markGilchrist/flightline-motor-controller/board_bottom.png

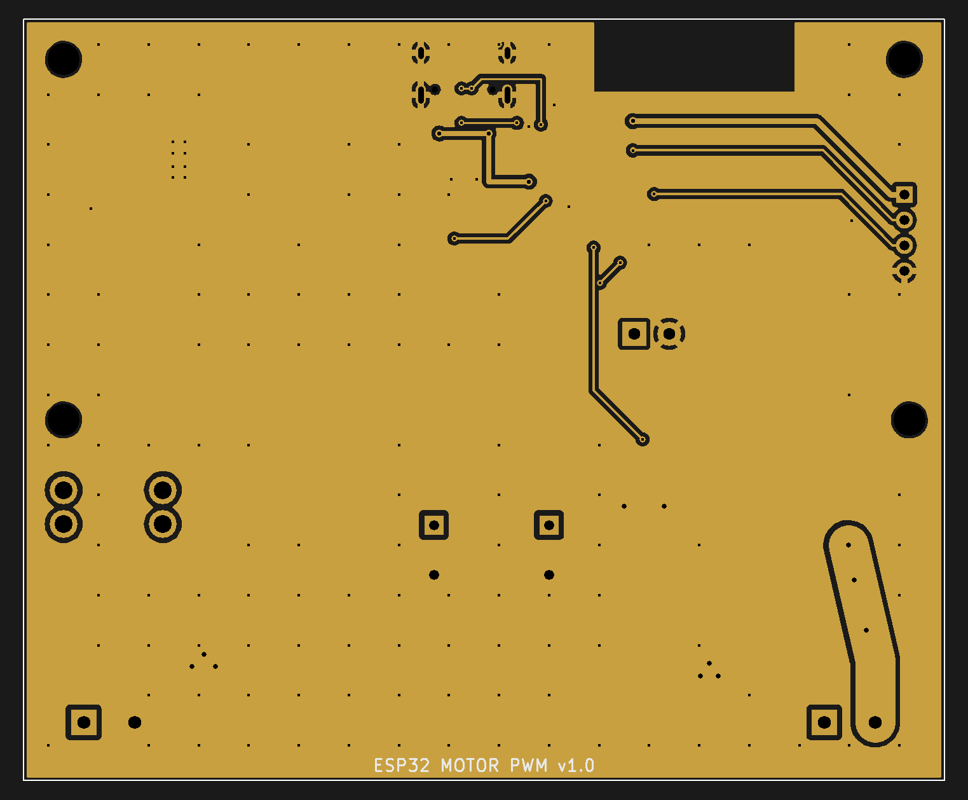
board_bottom.png
