markGilchrist/flightline-motor-controller/board_top.png

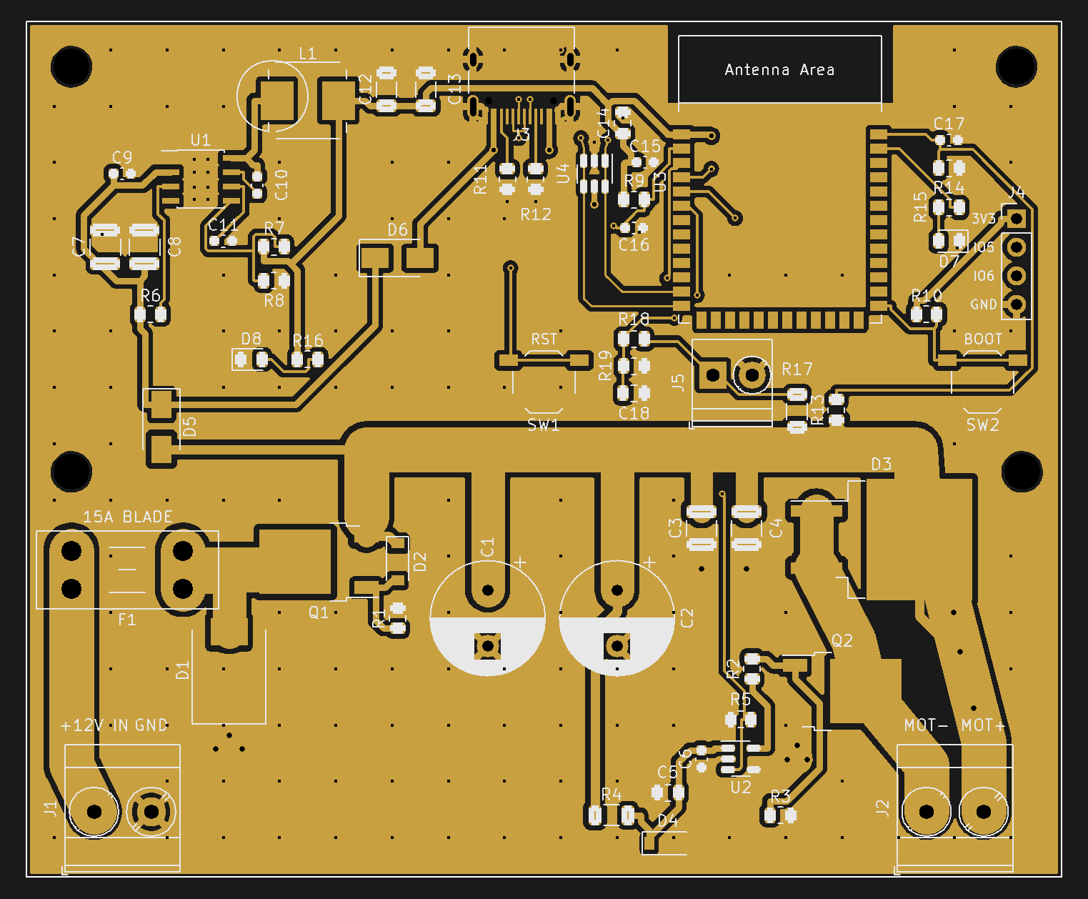
board_top.png
