markGilchrist/flightline-motor-controller/motor_ctrl_BOM.csv

Qty | References | Value | Footprint | Manufacturer part / notes
2 | C1 C2 | 470uF 35V | CP_Radial_D10.0mm_P5.00mm | Panasonic EEU-FR1V471
4 | C3 C4 C7 C8 | 10uF 50V | C_1210_3225Metric | X7R 1210
1 | C5 | 1uF 25V | C_0805_2012Metric
4 | C6 C10 C15 C17 | 100nF | C_0603_1608Metric
1 | C9 | 100nF 50V | C_0603_1608Metric
2 | C11 C16 | 1uF | C_0603_1608Metric
2 | C12 C13 | 22uF 10V | C_1206_3216Metric | X7R 1206
1 | C14 | 10uF | C_0805_2012Metric
1 | C18 | 470nF | C_0805_2012Metric
1 | D1 | SMCJ20CA | D_SMC | Littelfuse SMCJ20CA
2 | D2 D4 | BZT52C12 | D_SOD-123 | BZT52C12
1 | D3 | STPS20L45CG | TO-263-2 | ST STPS20L45CG-TR
2 | D5 D6 | B360A | D_SMA | Diodes B360A-13-F
1 | D7 | GREEN | LED_0805_2012Metric
1 | D8 | RED | LED_0805_2012Metric
1 | F1 | 15A | Fuseholder_Blade_Mini_Keystone_3568 | Keystone 3568 + 15A mini blade fuse
1 | J1 | BATTERY 12V | TerminalBlock_Phoenix_MKDS-3-2-5.08_1x02_P5.08mm_Horizontal | Phoenix 1711026 (MKDS 3/2-5.08)
1 | J2 | MOTOR | TerminalBlock_Phoenix_MKDS-3-2-5.08_1x02_P5.08mm_Horizontal | Phoenix 1711026 (MKDS 3/2-5.08)
1 | J3 | USB-C | USB_C_Receptacle_HRO_TYPE-C-31-M-12 | HRO TYPE-C-31-M-12
1 | J4 | AUX | PinHeader_1x04_P2.54mm_Vertical | 2.54 mm header
1 | J5 | PARK | TerminalBlock_Phoenix_PT-1,5-2-3.5-H_1x02_P3.50mm_Horizontal | Phoenix 1984617 (PT 1,5/2-3,5-H)
1 | L1 | 6.8uH | L_Bourns_SRP7028A_7.3x6.6mm | Bourns SRP7028A-6R8M
1 | Q1 | IPD90P04P4L-04 | TO-252-2 | Infineon IPD90P04P4L-04
1 | Q2 | IPD90N04S4L-04 | TO-252-2 | Infineon IPD90N04S4L-04
4 | R1 R3 R9 R10 | 10k | R_0805_2012Metric
1 | R2 | 10R | R_0805_2012Metric
1 | R4 | 220R | R_1206_3216Metric
2 | R5 R6 | 100k | R_0805_2012Metric
3 | R7 R13 R18 | 100k | R_0805_2012Metric | 1%
1 | R8 | 43.2k | R_0805_2012Metric | 1%
2 | R11 R12 | 5.1k | R_0805_2012Metric
1 | R14 | 18k | R_0805_2012Metric | 1%
2 | R15 R16 | 1k | R_0805_2012Metric
1 | R17 | 4k7 | R_1206_3216Metric
1 | R19 | 10k | R_0805_2012Metric | 1%
1 | SW1 | RESET | SW_SPST_TL3342 | E-Switch TL3342F160QG
1 | SW2 | BOOT | SW_SPST_TL3342 | E-Switch TL3342F160QG
1 | U1 | LMR33630ADDA | TI_SO-PowerPAD-8_ThermalVias | TI LMR33630ADDAR
1 | U2 | UCC27517A | SOT-23-5 | TI UCC27517ADBVR
1 | U3 | ESP32-S3-WROOM-1 | ESP32-S3-WROOM-1 | Espressif ESP32-S3-WROOM-1-N8
1 | U4 | USBLC6-2SC6 | SOT-23-6 | ST USBLC6-2SC6
