markGilchrist/flightline-motor-controller/motor_ctrl_schematic.pdf

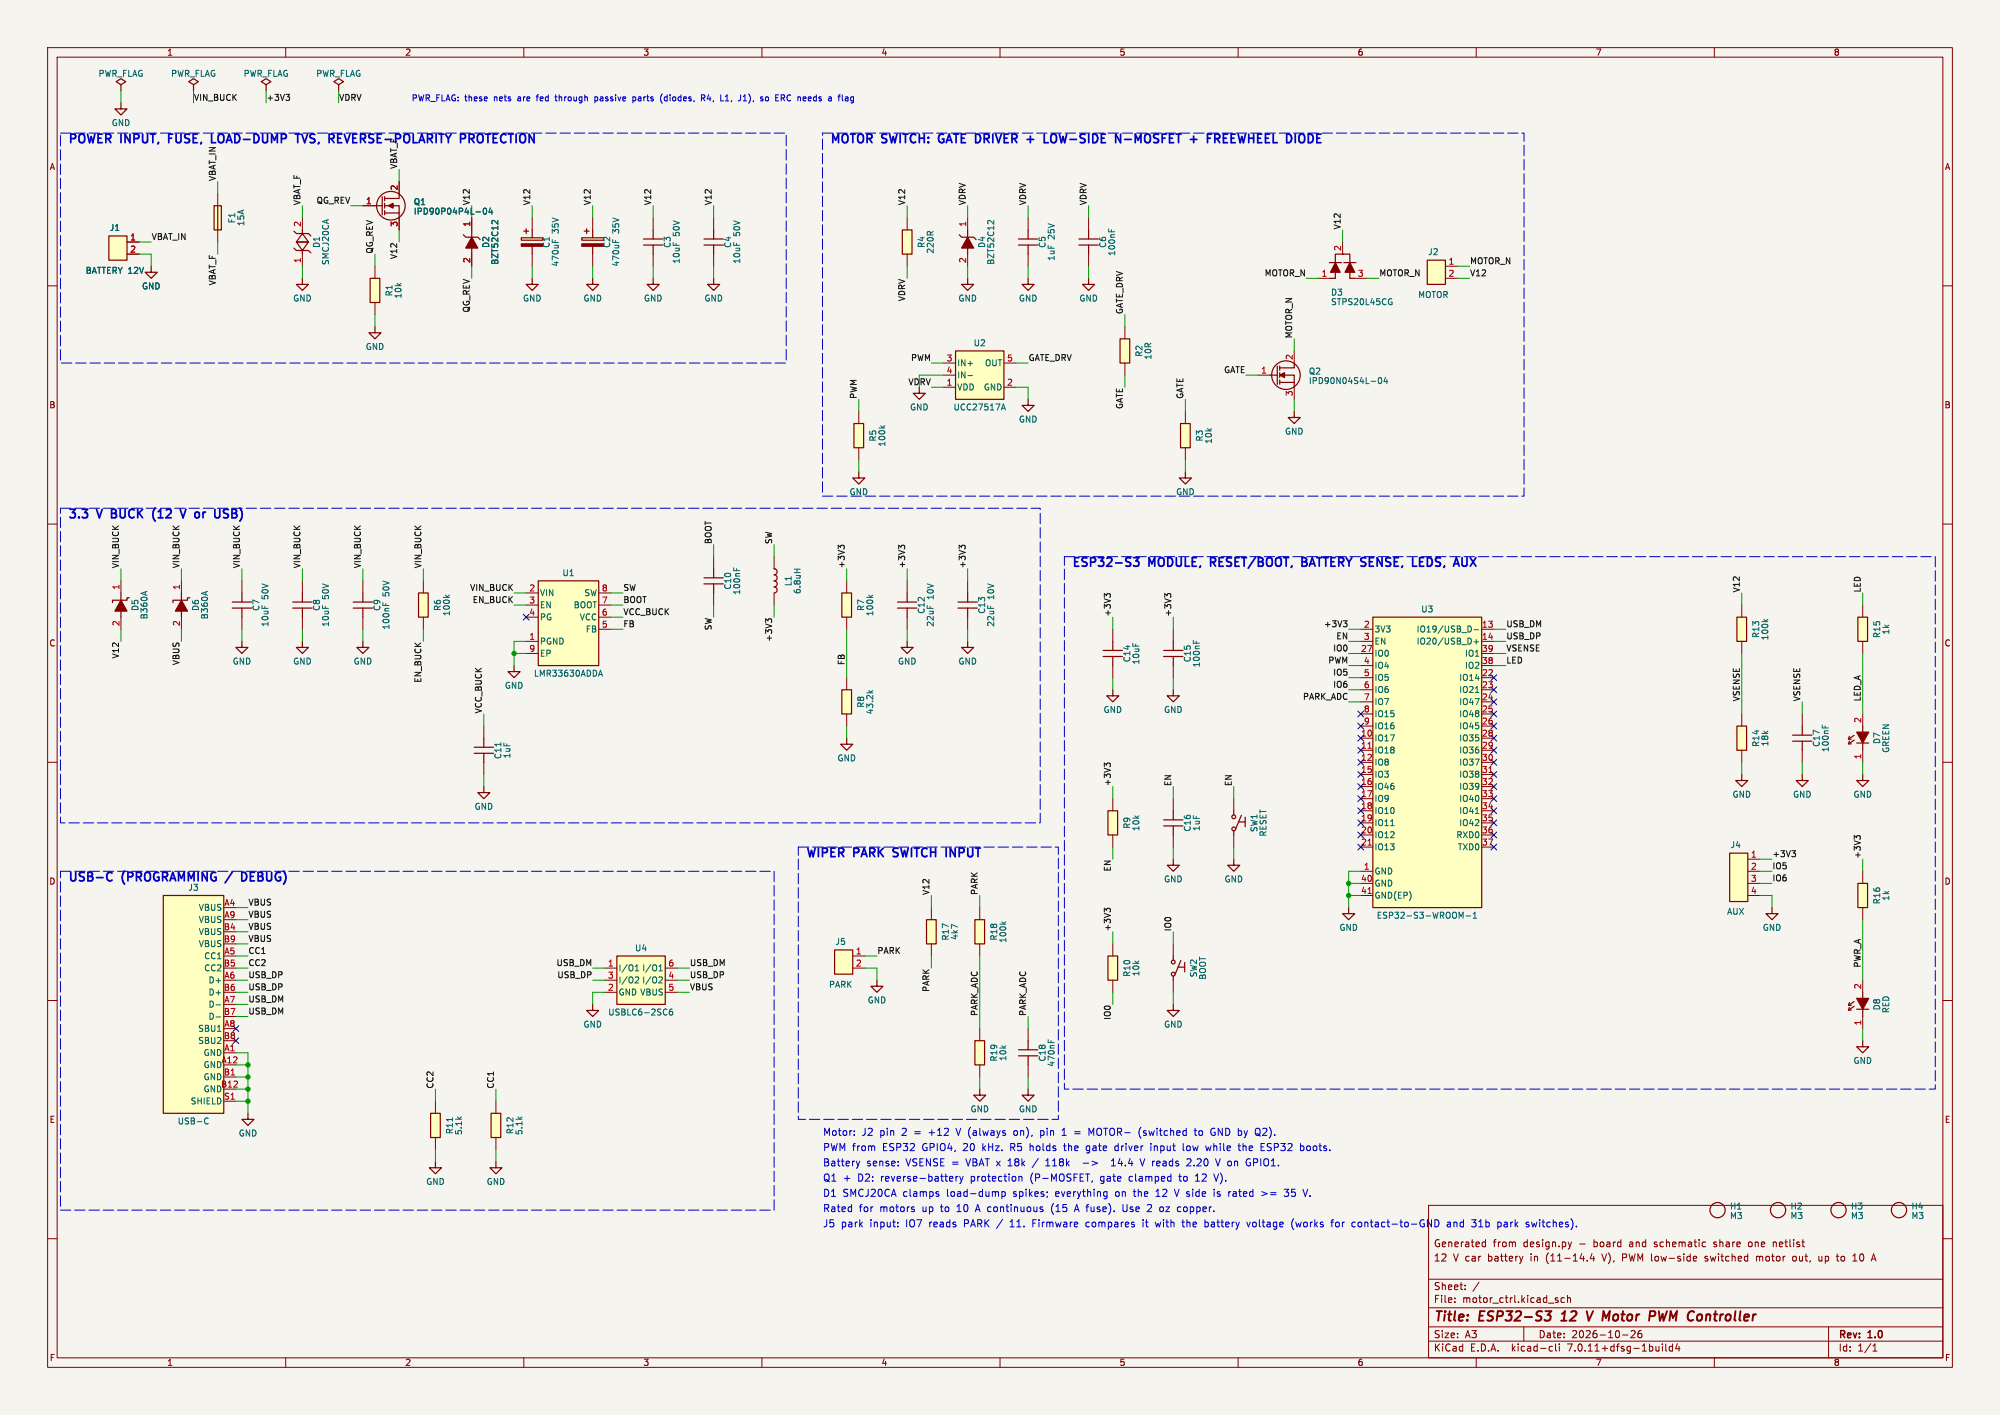
[picture p3: page 1]

POWER INPUT, FUSE, LOAD-DUMP TVS, REVERSE-POLARITY PROTECTION

MOTOR SWITCH: GATE DRIVER + LOW-SIDE N-MOSFET + FREEWHEEL DIODE

WIPER PARK SWITCH INPUT
