markGilchrist/flightline-motor-controller/motor_ctrl.kicad_pcb

## KiCad design motor_ctrl.kicad_pcb (2026-10-29)

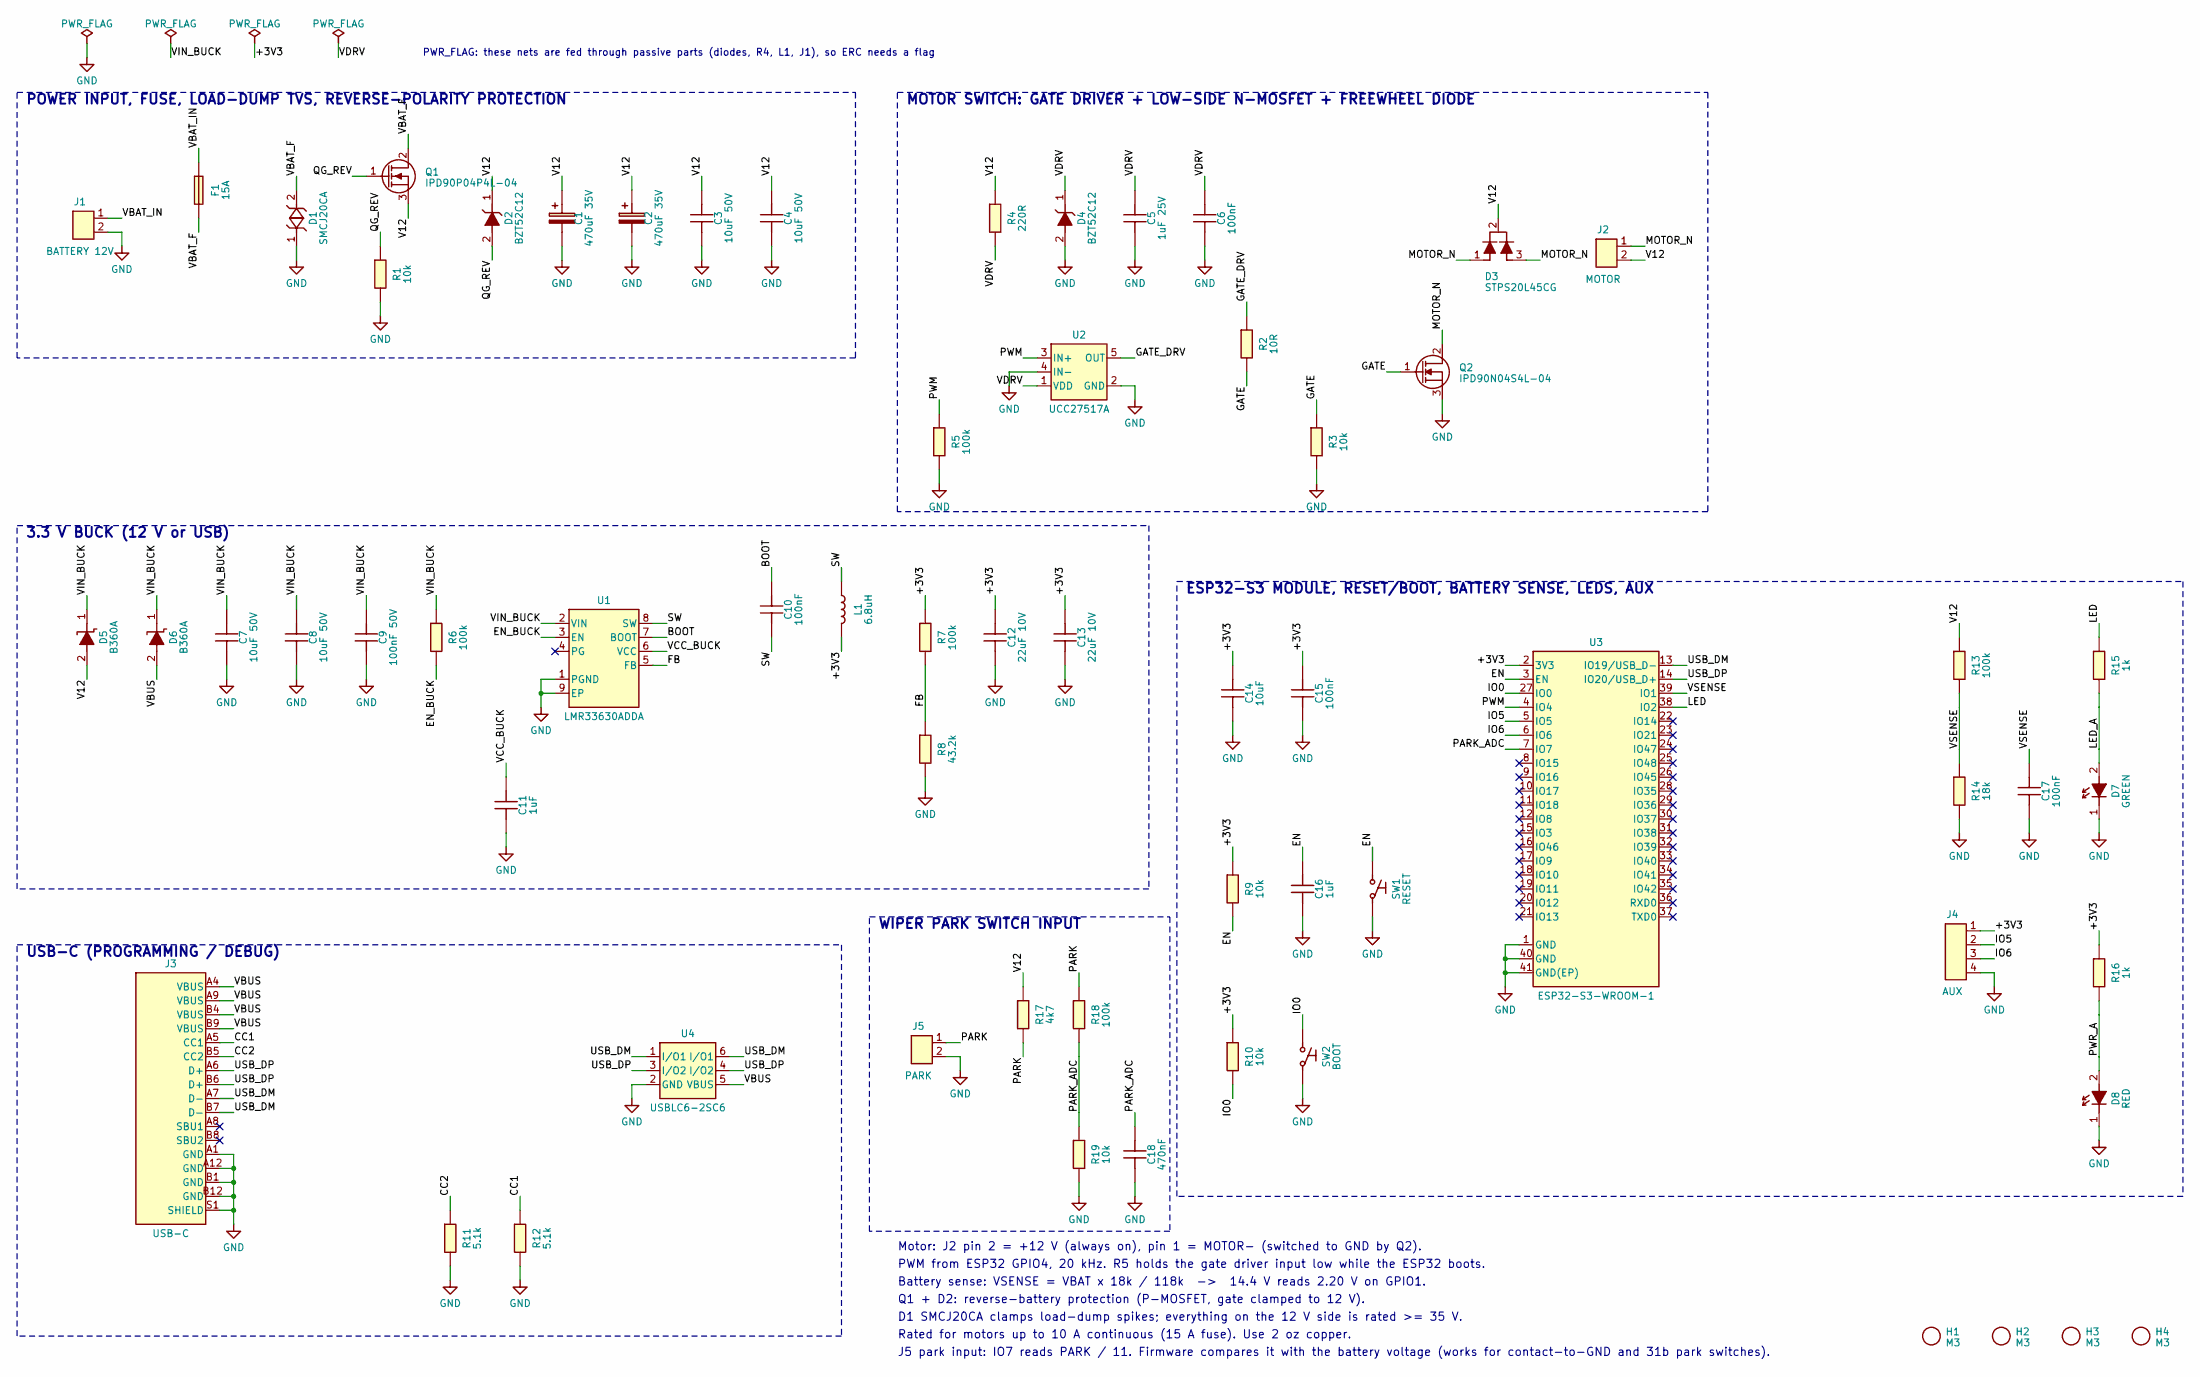
[picture p4: schematic motor_ctrl.kicad_sch, ESP32-S3 12 V Motor PWM Controller]

Parts:
C1, C2: 470uF 35V; CP_Radial_D10.0mm_P5.00mm; MPN Panasonic EEU-FR1V471
C3, C4, C7, C8: 10uF 50V; C_1210_3225Metric; MPN X7R 1210
C5: 1uF 25V; C_0805_2012Metric
C6, C10, C15, C17: 100nF; C_0603_1608Metric
C9: 100nF 50V; C_0603_1608Metric
C11, C16: 1uF; C_0603_1608Metric
C12, C13: 22uF 10V; C_1206_3216Metric; MPN X7R 1206
C14: 10uF; C_0805_2012Metric
C18: 470nF; C_0805_2012Metric
D1: SMCJ20CA; D_SMC; MPN Littelfuse SMCJ20CA
D2, D4: BZT52C12; D_SOD-123; MPN BZT52C12
D3: STPS20L45CG; TO-263-2; MPN ST STPS20L45CG-TR
D5, D6: B360A; D_SMA; MPN Diodes B360A-13-F
D7: GREEN; LED_0805_2012Metric
D8: RED; LED_0805_2012Metric
F1: 15A; Fuseholder_Blade_Mini_Keystone_3568; MPN Keystone 3568 + 15A mini blade fuse
H1, H2, H3, H4: M3; MountingHole_3.2mm_M3
J1: BATTERY 12V; TerminalBlock_Phoenix_MKDS-3-2-5.08_1x02_P5.08mm_Horizontal; MPN Phoenix 1711026 (MKDS 3/2-5.08)
J2: MOTOR; TerminalBlock_Phoenix_MKDS-3-2-5.08_1x02_P5.08mm_Horizontal; MPN Phoenix 1711026 (MKDS 3/2-5.08)
J3: USB-C; USB_C_Receptacle_HRO_TYPE-C-31-M-12; MPN HRO TYPE-C-31-M-12
J4: AUX; PinHeader_1x04_P2.54mm_Vertical; MPN 2.54 mm header
J5: PARK; TerminalBlock_Phoenix_PT-1,5-2-3.5-H_1x02_P3.50mm_Horizontal; MPN Phoenix 1984617 (PT 1,5/2-3,5-H)
L1: 6.8uH; L_Bourns_SRP7028A_7.3x6.6mm; MPN Bourns SRP7028A-6R8M
Q1: IPD90P04P4L-04; TO-252-2; MPN Infineon IPD90P04P4L-04
Q2: IPD90N04S4L-04; TO-252-2; MPN Infineon IPD90N04S4L-04
R1, R3, R9, R10: 10k; R_0805_2012Metric
R2: 10R; R_0805_2012Metric
R4: 220R; R_1206_3216Metric
R5, R6: 100k; R_0805_2012Metric
R7, R13, R18: 100k; R_0805_2012Metric; MPN 1%
R8: 43.2k; R_0805_2012Metric; MPN 1%
R11, R12: 5.1k; R_0805_2012Metric
R14: 18k; R_0805_2012Metric; MPN 1%
R15, R16: 1k; R_0805_2012Metric
R17: 4k7; R_1206_3216Metric
R19: 10k; R_0805_2012Metric; MPN 1%
SW1: RESET; SW_SPST_TL3342; MPN E-Switch TL3342F160QG
SW2: BOOT; SW_SPST_TL3342; MPN E-Switch TL3342F160QG
U1: LMR33630ADDA; TI_SO-PowerPAD-8_ThermalVias; MPN TI LMR33630ADDAR
U2: UCC27517A; SOT-23-5; MPN TI UCC27517ADBVR
U3: ESP32-S3-WROOM-1; MPN Espressif ESP32-S3-WROOM-1-N8
U4: USBLC6-2SC6; SOT-23-6; MPN ST USBLC6-2SC6

Connections:
+3V3: C12.1, C13.1, C14.1, C15.1, J4.1, L1.2, R7.1, R9.1, R10.1, R16.1, U3.2 (3V3)
BOOT: C10.1, U1.7 (BOOT)
CC1: J3.A5 (CC1), R12.1
CC2: J3.B5 (CC2), R11.1
EN: C16.1, R9.2, SW1.1, U3.3 (EN)
EN_BUCK: R6.2, U1.3 (EN)
FB: R7.2, R8.1, U1.5 (FB)
GATE: Q2.1 (G), R2.2, R3.1
GATE_DRV: R2.1, U2.5 (OUT)
GND: C1.2, C2.2, C3.1, C4.1, C5.2, C6.1, C7.2, C8.2, C9.2, C11.2, C12.2, C13.2, C14.2, C15.2, C16.2, C17.2, C18.2, D1.1 (A1), D4.2 (A), D7.1 (K), D8.1 (K), J1.2, J3.A1 (GND), J3.A12 (GND), J3.B1 (GND), J3.B12 (GND), J3.S1 (SHIELD), J4.4, J5.2, Q2.3 (S), R1.2, R3.2, R5.2, R8.2, R11.2, R12.2, R14.2, R19.2, SW1.2, SW2.2, U1.1 (PGND), U1.9 (EP), U2.2 (GND), U2.4 (IN-), U3.1 (GND), U3.40 (GND), U3.41 (GND(EP)), U4.2 (GND)
IO0: R10.2, SW2.1, U3.27 (IO0)
IO5: J4.2, U3.5 (IO5)
IO6: J4.3, U3.6 (IO6)
LED: R15.1, U3.38 (IO2)
LED_A: D7.2 (A), R15.2
MOTOR_N: D3.1 (A1), D3.3 (A2), J2.1, Q2.2 (D)
PARK: J5.1, R17.2, R18.1
PARK_ADC: C18.1, R18.2, R19.1, U3.7 (IO7)
PWM: R5.1, U2.3 (IN+), U3.4 (IO4)
PWR_A: D8.2 (A), R16.2
QG_REV: D2.2 (A), Q1.1 (G), R1.1
SW: C10.2, L1.1, U1.8 (SW)
USB_DM: J3.A7 (D-), J3.B7 (D-), U3.13 (IO19/USB_D-), U4.1 (I/O1), U4.6 (I/O1)
USB_DP: J3.A6 (D+), J3.B6 (D+), U3.14 (IO20/USB_D+), U4.3 (I/O2), U4.4 (I/O2)
V12: C1.1, C2.1, C3.2, C4.2, D2.1 (K), D3.2 (K), D5.2 (A), J2.2, Q1.3 (S), R4.1, R13.1, R17.1
VBAT_F: D1.2 (A2), F1.2, Q1.2 (D)
VBAT_IN: F1.1, J1.1
VBUS: D6.2 (A), J3.A4 (VBUS), J3.A9 (VBUS), J3.B4 (VBUS), J3.B9 (VBUS), U4.5 (VBUS)
VCC_BUCK: C11.1, U1.6 (VCC)
VDRV: C5.1, C6.2, D4.1 (K), R4.2, U2.1 (VDD)
VIN_BUCK: C7.1, C8.1, C9.1, D5.1 (K), D6.1 (K), R6.1, U1.2 (VIN)
VSENSE: C17.1, R13.2, R14.1, U3.39 (IO1)

Notes on the sheet:
PWR_FLAG: these nets are fed through passive parts (diodes, R4, L1, J1), so ERC needs a flag
POWER INPUT, FUSE, LOAD-DUMP TVS, REVERSE-POLARITY PROTECTION
MOTOR SWITCH: GATE DRIVER + LOW-SIDE N-MOSFET + FREEWHEEL DIODE
3.3 V BUCK (12 V or USB)
ESP32-S3 MODULE, RESET/BOOT, BATTERY SENSE, LEDS, AUX
USB-C (PROGRAMMING / DEBUG)
WIPER PARK SWITCH INPUT
Motor: J2 pin 2 = +12 V (always on), pin 1 = MOTOR- (switched to GND by Q2).
PWM from ESP32 GPIO4, 20 kHz. R5 holds the gate driver input low while the ESP32 boots.
Battery sense: VSENSE = VBAT x 18k / 118k -> 14.4 V reads 2.20 V on GPIO1.
Q1 + D2: reverse-battery protection (P-MOSFET, gate clamped to 12 V).
D1 SMCJ20CA clamps load-dump spikes; everything on the 12 V side is rated >= 35 V.
Rated for motors up to 10 A continuous (15 A fuse). Use 2 oz copper.
J5 park input: IO7 reads PARK / 11. Firmware compares it with the battery voltage (works for contact-to-GND and 31b park switches).

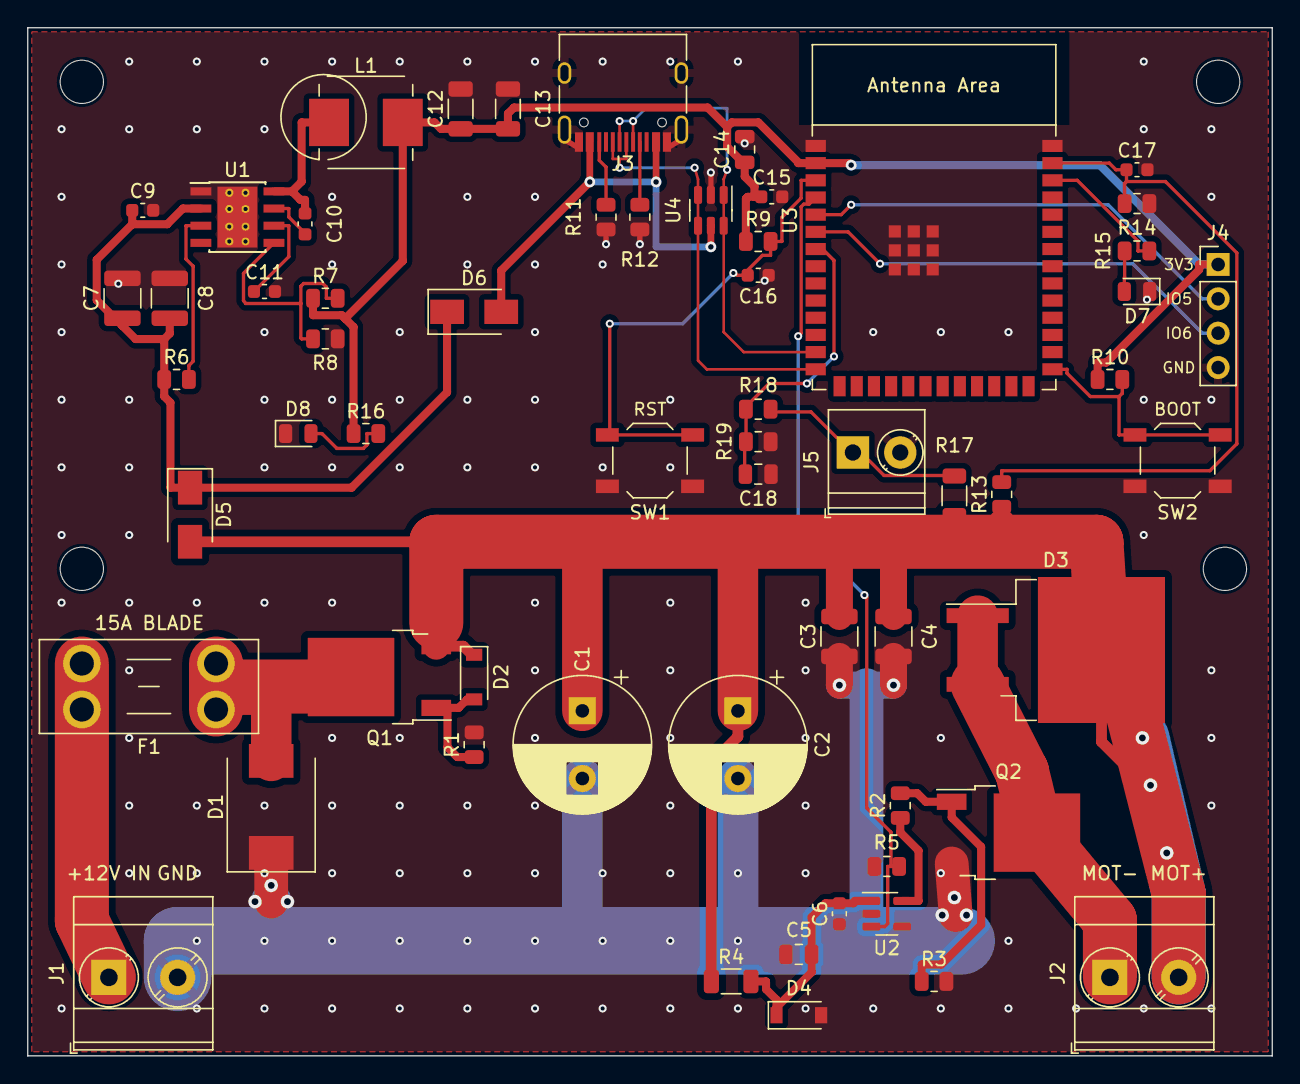
[picture p5: board motor_ctrl.kicad_pcb from above]

Board: 2 copper layers, 92.0 x 76.0 mm, 64 parts (0 on the bottom side), 32 nets.
