markGilchrist/flightline-motor-controller/generator_scripts/power_routes.py

"""Hand-routed high-current copper (fixed; the autorouter routes around it).
Coordinates are board-relative mm. Width 4 mm on 2 oz copper ~ 10 A with <20 C rise."""

TRACKS = [
    # net, layer, width, polyline
    ('VBAT_IN', 'F.Cu', 4.0, [(6.0, 70.2), (4.0, 66.0), (4.0, 47.0)]),
    ('VBAT_F', 'F.Cu', 4.0, [(13.92, 47.0), (13.92, 50.4)]),
    ('VBAT_F', 'F.Cu', 4.0, [(13.92, 48.7), (23.9, 48.7)]),
    ('VBAT_F', 'F.Cu', 3.0, [(18.0, 48.7), (18.0, 54.2)]),
    # V12 bus: Q1 source -> bulk caps -> freewheel diode tab -> motor terminal
    ('V12', 'F.Cu', 2.0, [(30.2, 45.72), (30.2, 44.0)]),
    ('V12', 'F.Cu', 4.0, [(30.2, 44.0), (30.2, 38.0), (79.0, 38.0), (79.38, 44.0)]),
    ('V12', 'F.Cu', 3.0, [(41.0, 38.0), (41.0, 50.5)]),
    ('V12', 'F.Cu', 3.0, [(52.5, 38.0), (52.5, 50.5)]),
    ('V12', 'F.Cu', 2.0, [(60.0, 38.0), (60.0, 43.525)]),
    ('V12', 'F.Cu', 2.0, [(64.0, 38.0), (64.0, 43.525)]),
    ('V12', 'F.Cu', 2.0, [(72.0, 38.0), (72.0, 36.6)]),
    ('V12', 'F.Cu', 0.8, [(72.0, 36.6), (72.0, 35.41)]),
    ('V12', 'F.Cu', 4.0, [(81.5, 50.0), (85.08, 64.0), (85.08, 70.2)]),
    # bottom copy starts at the first stitching via: D3's tab is a top-only SMD pad
    ('V12', 'B.Cu', 4.0, [(82.4, 52.5), (85.08, 64.0), (85.08, 70.2)]),
    # MOTOR_N: diode anodes -> MOSFET drain tab -> motor terminal
    ('MOTOR_N', 'F.Cu', 3.0, [(70.22, 43.46), (70.22, 48.54)]),
    ('MOTOR_N', 'F.Cu', 4.0, [(70.22, 48.54), (73.5, 55.0), (74.6, 59.5)]),
    ('MOTOR_N', 'F.Cu', 4.0, [(74.6, 59.5), (80.0, 66.0), (80.0, 70.2)]),
    # GND return: bottom-layer bus from MOSFET source to battery terminal
    ('GND', 'B.Cu', 5.0, [(11.08, 70.2), (11.08, 67.5), (69.0, 67.5)]),
    ('GND', 'B.Cu', 3.0, [(41.0, 55.5), (41.0, 67.5)]),
    ('GND', 'B.Cu', 3.0, [(52.5, 55.5), (52.5, 67.5)]),
    ('GND', 'B.Cu', 2.5, [(62.0, 48.6), (62.0, 67.5)]),
    ('GND', 'B.Cu', 2.0, [(60.0, 48.6), (64.0, 48.6)]),
    ('GND', 'F.Cu', 2.0, [(60.0, 46.475), (60.0, 48.6)]),
    ('GND', 'F.Cu', 2.0, [(64.0, 46.475), (64.0, 48.6)]),
    ('GND', 'F.Cu', 2.5, [(68.3, 61.78), (68.6, 65.6)]),
    ('GND', 'F.Cu', 2.5, [(18.0, 61.0), (18.0, 64.6)]),
    ('GND', 'B.Cu', 3.0, [(18.0, 64.6), (18.0, 67.5)]),
]

# ---- USB-C breakout (hand routed; HRO TYPE-C-31-M-12 has doubled D+/D- pads that interleave) ----
TRACKS += [
    # D+ : B6 + A6 joined just below the pads, dropped to bottom, up again into U4 pin 3, out of pin 4 to ESP32 IO20
    ('USB_DP', 'F.Cu', 0.2, [(43.25, 8.445), (43.25, 9.7), (44.25, 9.7), (44.25, 8.445)]),
    ('USB_DP', 'F.Cu', 0.2, [(43.75, 9.7), (43.75, 10.35)]),
    ('USB_DP', 'B.Cu', 0.2, [(43.75, 10.35), (49.3, 10.35)]),
    ('USB_DP', 'F.Cu', 0.2, [(49.3, 10.35), (49.55, 11.2), (49.55, 12.36)]),
    ('USB_DP', 'F.Cu', 0.2, [(49.55, 14.64), (49.55, 24.6), (50.2, 25.25), (58.25, 25.25)]),
    # D- : A7 + B7 each dropped through a via above the pads, joined on bottom, into U4 pin 1, out of pin 6 to IO19
    ('USB_DM', 'F.Cu', 0.2, [(43.75, 8.445), (43.75, 6.9)]),
    ('USB_DM', 'F.Cu', 0.2, [(44.75, 8.445), (44.75, 6.9)]),
    ('USB_DM', 'B.Cu', 0.2, [(43.75, 6.9), (44.75, 6.9), (45.7, 5.95), (51.7, 5.95), (51.7, 10.5)]),
    ('USB_DM', 'F.Cu', 0.2, [(51.7, 10.5), (51.45, 11.2), (51.45, 12.36)]),
    ('USB_DM', 'F.Cu', 0.2, [(51.45, 14.64), (51.45, 22.5), (52.93, 23.98), (58.25, 23.98)]),
    # CC pull-downs
    ('CC2', 'F.Cu', 0.25, [(42.25, 8.445), (42.25, 9.8), (42.75, 10.3), (42.75, 13.088)]),
    ('CC1', 'F.Cu', 0.25, [(45.25, 8.445), (45.25, 13.088)]),
    ('GND', 'F.Cu', 0.4, [(42.75, 14.912), (42.75, 16.0)]),
    ('GND', 'F.Cu', 0.4, [(45.25, 14.912), (45.25, 16.0)]),
    ('GND', 'F.Cu', 0.4, [(50.5, 12.36), (50.5, 10.7)]),
    ('GND', 'F.Cu', 0.4, [(40.75, 8.9), (39.9, 8.4)]),
    ('GND', 'F.Cu', 0.4, [(47.25, 8.9), (48.1, 8.4)]),
    # VBUS: both connector pads, joined on bottom, to U4 pin 5 (D6 / buck input is routed by the autorouter)
    ('VBUS', 'F.Cu', 0.5, [(41.55, 8.445), (41.55, 11.4)]),
    ('VBUS', 'F.Cu', 0.5, [(46.45, 8.445), (46.45, 11.4)]),
    ('VBUS', 'B.Cu', 0.5, [(41.55, 11.4), (46.45, 11.4), (46.45, 16.2), (50.5, 16.2)]),
    ('VBUS', 'F.Cu', 0.5, [(50.5, 16.2), (50.5, 14.64)]),
]
USB_VIAS = [  # net, x, y, size, drill
    ('USB_DP', 43.75, 10.35, 0.6, 0.3), ('USB_DP', 49.3, 10.35, 0.6, 0.3),
    ('USB_DM', 43.75, 6.9, 0.6, 0.3), ('USB_DM', 44.75, 6.9, 0.6, 0.3), ('USB_DM', 51.7, 10.5, 0.6, 0.3),
    ('GND', 42.75, 16.0, 0.6, 0.3), ('GND', 45.25, 16.0, 0.6, 0.3), ('GND', 50.5, 10.7, 0.6, 0.3),
    ('VBUS', 41.55, 11.4, 0.8, 0.4), ('VBUS', 46.45, 11.4, 0.8, 0.4), ('VBUS', 50.5, 16.2, 0.8, 0.4),
]

VIAS = [  # net, x, y  (1.0 mm pad / 0.5 mm drill)
    ('GND', 60.0, 48.6), ('GND', 64.0, 48.6),
    ('GND', 67.6, 65.6), ('GND', 69.4, 65.6), ('GND', 68.5, 64.3),
    ('GND', 16.8, 64.6), ('GND', 19.2, 64.6), ('GND', 18.0, 63.4),
    ('V12', 83.0, 56.0), ('V12', 84.2, 61.0), ('V12', 82.4, 52.5),
]
VIA_SIZE, VIA_DRILL = 1.0, 0.5

def all_vias():
    return [(n, x, y, VIA_SIZE, VIA_DRILL) for n, x, y in VIAS] + USB_VIAS
