markGilchrist/flightline-motor-controller/(commit log)

2026-10-29 Import delivered ESP32 motor controller (v1.0 as handed off)
    [filled.kicad_pcb, motor_ctrl.kicad_pcb, motor_ctrl.kicad_sch, motor_ctrl_BOM.csv]
2026-10-29 PCB: clear KiCad DRC errors, tidy silkscreen, fill zones
    First run of real KiCad DRC (7.0.11) on the generated board found:
    - 8 clearance errors inside the USB-C footprint (VBUS/GND pads are
    0.2 mm apart by design vs 0.25 mm Supply class): J3 footprint
    clearance override set to 0.2 mm.
    - 4 starved thermal reliefs on U1's exposed-pad vias: U1 footprint
    zone connection set to solid (also better for heat).
    - Dangling V12 track on B.Cu under D3's top-only tab: bottom copy now
    starts at the first stitching via.
    - Silkscreen overlaps/edge clipping: new place_refs.py moves reference
    designators to clean spots; mounting-hole refs hidden; J4 pin labels
    split per pin at 0.8 mm (min text he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
    [filled.kicad_pcb, motor_ctrl.kicad_pcb]
2026-10-29 PCB: extend antenna keepout to board edge; add fab outputs
    The ESP32 footprint's own keepout stops 1.25 mm short of the top edge,
    which left a strip of GND pour beside the antenna on both layers. A
    board-level keepout (x 57-77, y 0-7.2) now clears it to the edge.
    Nothing routed was inside it; DRC unchanged, 0 unconnected.
    Fab outputs (fab/), generated with make_fab.sh from the filled board:
    Gerbers (copper, mask, paste, silk, edge), separate PTH/NPTH Excellon
    drill files with maps, and a pick-and-place CSV. Drill/place origin is
    the board's bottom-left corner. gerbv renders in fab/gerber_*.png.
    Claude-Session: https://claude.ai/code/s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
    [motor_ctrl-B_Cu.gbl, motor_ctrl-B_Mask.gbs, motor_ctrl-B_Paste.gbp, motor_ctrl-B_Silkscreen.gbo, motor_ctrl-Edge_Cuts.gm1, motor_ctrl-F_Cu.gtl, motor_ctrl-F_Mask.gts, motor_ctrl-F_Paste.gtp]
2026-10-29 Schematic: KiCad 7 format, ERC clean, linked to the board
    - gen_sch.py writes the KiCad 7 file format (20230121), which KiCad 7,
    8 and 9 all open; the KiCad 8 format could not be read by KiCad 7.
    - Real KiCad ERC (eeschema 7.0.11) first reported 4 "power input not
    driven" errors (VIN_BUCK, GND, VDRV, +3V3: all fed through passive
    parts). Added PWR_FLAGs on those nets. ERC is now 0 errors, 0
    warnings.
    - The generated symbols are also written to motor_ctrl.kicad_sym with a
    project sym-lib-table, so the motor_ctrl library resolves and the
    symbols are editable.
    - Symbol UUIDs derive from the reference (design.sym_uuid) and
    build_pcb.py writes them as footprint paths, so KiCad links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
    [motor_ctrl-B_Cu.gbl, motor_ctrl-B_Mask.gbs, motor_ctrl-B_Paste.gbp, motor_ctrl-B_Silkscreen.gbo, motor_ctrl-Edge_Cuts.gm1, motor_ctrl-F_Cu.gtl, motor_ctrl-F_Mask.gts, motor_ctrl-F_Paste.gtp]
2026-10-29 Firmware: ramp up from 0 after a battery fault; add host tests
    Bug: during a battery fault loop() kept evaluating the ramp, so
    currentPct climbed back to the step's target while the output was held
    at 0. On recovery rampTo() started from that value, stepping the motor
    from 0 to full duty instantly (manual mode: straight to the last 's'
    speed). Now the ramp is frozen at 0 while faulted and recovery ramps up
    from 0 to the program step or the manual target.
    Pot mode (USE_POT) wrote the pot value straight to the output, with the
    same jump on recovery; the pot now sets the target and the ramp follows
    it (300 ms), bottom 2 % of travel = off.
    firmware/test: the sketch compiled on the host with -W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
    [motor_pwm.ino, test_motor_pwm.cpp]
2026-10-29 Docs: update README and handoff for session 2
    README: ready-made Gerbers in fab/, verification status, battery
    fault/restart behaviour, firmware tests; board renders replaced by
    renders of the actual Gerbers.
    CLAUDE.md: deliverables, keepout and footprint overrides, the pinned
    footprint-library versions needed to rebuild, the session 2 build and
    check pipeline, verification results, revised open items and history.
    Claude-Session: https://claude.ai/code/session_01PLwf3QU8QPKZDxUzVMVmef
2026-10-29 Docs: record wiper motor as the largest load
    The user confirmed the largest motor is a windscreen wiper motor. The
    10 A continuous / 15 A fuse ratings stay. README gets wiper wiring
    notes; CLAUDE.md records the open questions: whether the motor's
    ground is bonded to a chassis-mounted case (low-side switching would
    not work) and whether park-switch support is wanted.
    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
2026-10-29 Add wiper park-switch input (J5 -> IO7)
    The user drives a windscreen wiper motor and wants the blades parked
    during pauses, so the motor's park contact needs an input.
    - J5 (Phoenix PT 1,5 3.5 mm, 2-pin): 1 = PARK, 2 = GND.
    - R17 4k7 (1206) pulls PARK up to V12: open contact reads 12 V and
    the cam contact gets ~3 mA of wetting current.
    - R18 100k / R19 10k scale PARK by 1/11, so a 32 V load dump gives
    2.9 V at the pin; no clamp needed. C18 470 nF (tau 4.3 ms) removes
    the 20 kHz ripple a 31b-style park contact sees through MOTOR_N.
    - PARK_ADC goes to U3 pin 7 = IO7 (ADC1_CH6).
    PCB: parts placed below the module, routed by the new route_extra.py
    (two-layer grid A* that leaves the froze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
    [motor_ctrl-B_Cu.gbl, motor_ctrl-B_Mask.gbs, motor_ctrl-B_Paste.gbp, motor_ctrl-B_Silkscreen.gbo, motor_ctrl-Edge_Cuts.gm1, motor_ctrl-F_Cu.gtl, motor_ctrl-F_Mask.gts, motor_ctrl-F_Paste.gtp]
2026-10-29 Firmware: park the wiper blades on pause/stop
    USE_PARK (default on): a program pause, 'stop', 's 0' or the pot at
    zero now runs the motor at PARK_PCT (70 %) until the park input on IO7
    reads "parked" three samples in a row, then cuts. The pause time counts
    from the moment it parks.
    "Parked" = park voltage below half the battery voltage. That covers a
    contact to GND (0 V at park) and car-style 31b terminals, which switch
    to the motor's own ground (here the PWM-switched MOTOR_N, about 30 % of
    Vbat at 70 % duty after the RC filter). PARK_INVERT for contacts that
    open at park. If no park position is seen within 6 s (switch unwired),
    the motor stops anyway and a warning is printed. A battery fau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
2026-10-29 Docs: park switch wiring, mounting, handoff update
    README: J5 in the wiring table; wiper section rewritten for the
    user's setup (separate device, spade connectors) with park-switch
    wiring for contact-to-GND, 31b and normally-closed switches, and how
    to check it with 'v'.
    CLAUDE.md: user answers recorded, park-input circuit and layout,
    netlist and pin table, route_extra.py in the pipeline, firmware parking
    design, verification results (DRC clean, 64/64 parts, 32/32 nets, four
    test builds), and the remaining step: bench-test parking with the
    actual motor.
    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
2026-10-29 Firmware: speak the FlightLine Controller app protocol over BLE
    The board now works with the user's FlightLine Controller apps
    (markGilchrist/flightline-ios and flightline-android). The protocol is
    taken from the apps' code:
    - BLE peripheral named "Flightline", service FFE0, characteristic FFE1
    (read/write/write-no-response/notify + 2902), as the HM-10 modules
    the apps were written for.
    - 5-character commands: aT?bb -> ty1; aS?bb/aN?bb/aF?bb/aB?bb/aC?bb ->
    sp/on/of/XX/xx replies; aS### aN### aF### set speed and on/off times;
    axXXX/ayYYY cycle on/off; aXXXX/aYYYY quick burst on/off. Parsed as
    a byte stream, so split or joined writes work.
    - Normal cycle: run at speed for the on tim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
2026-11-01 Add CI workflow: firmware simulation tests and ESP32-S3 compile
    Runs firmware/test/run_tests.sh (host build against the mock API) and
    compiles firmware/motor_pwm with arduino-cli for the ESP32S3 Dev Module
    on Arduino-ESP32 core 3.3.12.
    Claude-Session: https://claude.ai/code/session_01PLwf3Qkcqzqph5TiQkHDpW
2026-11-01 Firmware: declare enum Source before the first function
    The Arduino builder inserts generated prototypes before the first function
    definition, so reply(), handleAppCommand() and feedAppBytes() referenced
    Source before it existed and the real ESP32-S3 compile failed.
    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
    [motor_pwm.ino]
